hairymnstr/usb-thinkpad-keyboard/sch/thinkpad_keyboard_usb.kicad_pcb

## KiCad design sch/thinkpad_keyboard_usb.kicad_pcb (2025-03-06)

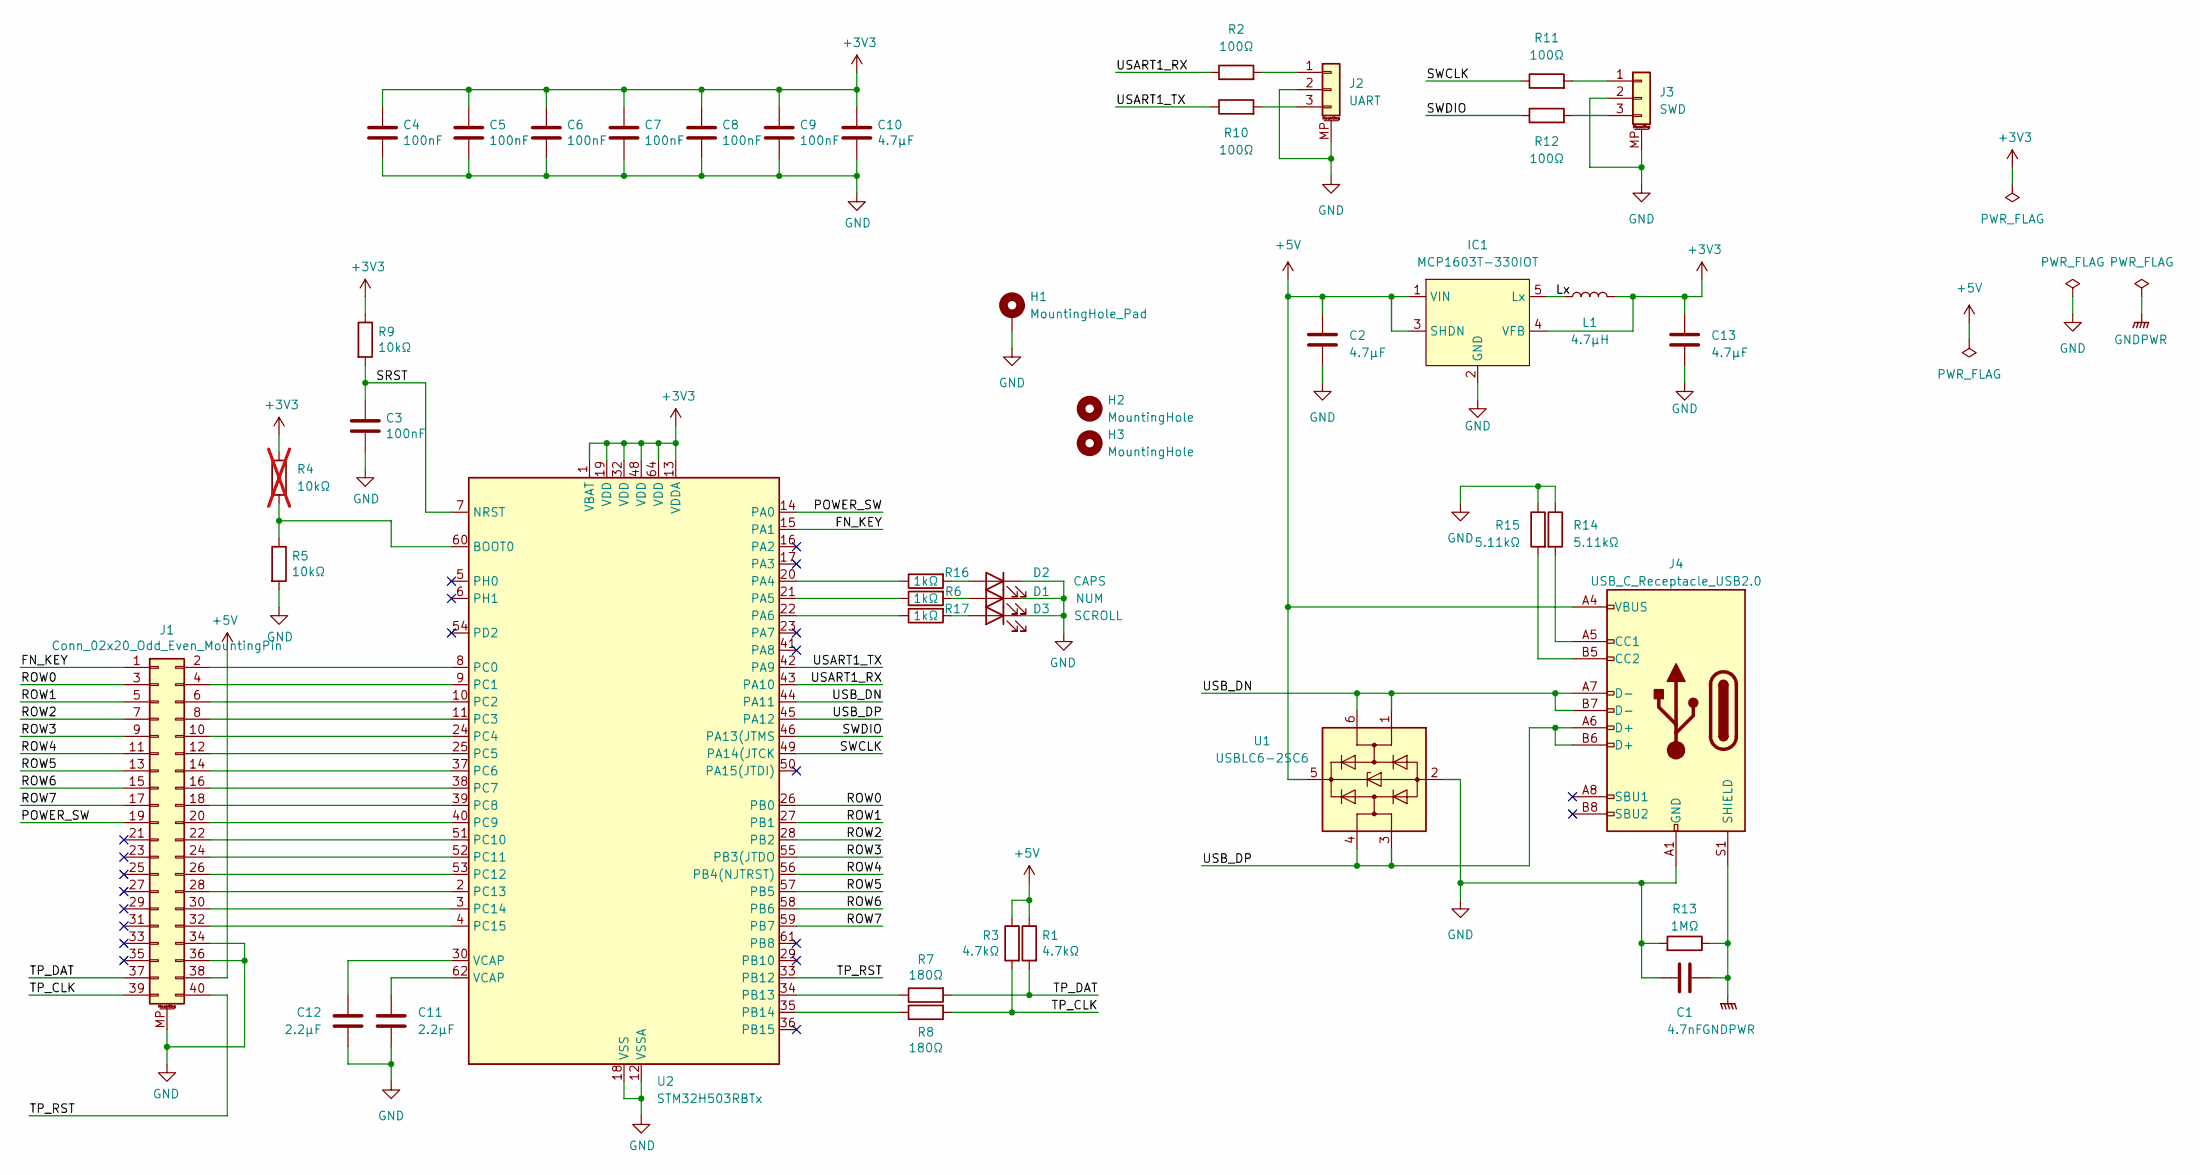
[picture p1: schematic thinkpad_keyboard_usb.kicad_sch]

Parts:
C1: 4.7nF; C_0805_2012Metric
C2, C10, C13: 4.7µF; C_0805_2012Metric
C3, C4, C5, C6, C7, C8, C9: 100nF; C_0603_1608Metric
C11, C12: 2.2µF; C_0603_1608Metric
D1: NUM; D_0603_1608Metric
D2: CAPS; D_0603_1608Metric
D3: SCROLL; D_0603_1608Metric
H1: MountingHole_Pad; MountingHole_2.2mm_M2_Pad
H2, H3: MountingHole; MountingHole_3.2mm_M3
IC1: MCP1603T-330IOT; TSOT-23-5
J1: Conn_02x20_Odd_Even_MountingPin; MOLEX_SLIMSTACK_54363_02x20_P0.5mm
J2: UART; JST_SH_SM03B-SRSS-TB_1x03-1MP_P1.00mm_Horizontal
J3: SWD; JST_SH_SM03B-SRSS-TB_1x03-1MP_P1.00mm_Horizontal
J4: USB_C_Receptacle_USB2.0; USB_C_Receptacle_GCT_USB4085
L1: 4.7µH; L_Wuerth_WE-TPC-3816
R1, R3: 4.7kΩ; R_0603_1608Metric
R2, R10, R11, R12: 100Ω; R_0603_1608Metric
R4: 10kΩ; R_0603_1608Metric; not fitted
R5, R9: 10kΩ; R_0603_1608Metric
R6, R16, R17: 1kΩ; R_0603_1608Metric
R7, R8: 180Ω; R_0603_1608Metric
R13: 1MΩ; R_0603_1608Metric
R14, R15: 5.11kΩ; R_0603_1608Metric
U1: USBLC6-2SC6; SOT-23-6
U2: STM32H503RBTx; LQFP-64_10x10mm_P0.5mm

Connections:
+3V3: C4.1, C5.1, C6.1, C7.1, C8.1, C9.1, C10.1, C13.1, IC1.4 (VFB), L1.2, R4.1, R9.1, U2.1 (VBAT), U2.13 (VDDA), U2.19 (VDD), U2.32 (VDD), U2.48 (VDD), U2.64 (VDD)
+5V: C2.1, IC1.1 (VIN), IC1.3 (SHDN), J1.38, J4.A4 (VBUS), J4.A9 (VBUS), J4.B4 (VBUS), J4.B9 (VBUS), R1.1, R3.1, U1.5 (VBUS)
/FN_KEY: J1.1, U2.15 (PA1)
/Lx: IC1.5 (Lx), L1.1
/POWER_SW: J1.19, U2.14 (PA0)
/ROW0: J1.3, U2.26 (PB0)
/ROW1: J1.5, U2.27 (PB1)
/ROW2: J1.7, U2.28 (PB2)
/ROW3: J1.9, U2.55 (PB3(JTDO)
/ROW4: J1.11, U2.56 (PB4(NJTRST))
/ROW5: J1.13, U2.57 (PB5)
/ROW6: J1.15, U2.58 (PB6)
/ROW7: J1.17, U2.59 (PB7)
/SRST: C3.1, R9.2, U2.7 (NRST)
/SWCLK: R11.1, U2.49 (PA14(JTCK)
/SWDIO: R12.1, U2.46 (PA13(JTMS)
/TP_CLK: J1.39, R3.2, R8.2
/TP_DAT: J1.37, R1.2, R7.2
/TP_RST: J1.40, U2.33 (PB12)
/USART1_RX: R2.1, U2.43 (PA10)
/USART1_TX: R10.1, U2.42 (PA9)
/USB_DN: J4.A7 (D-), J4.B7 (D-), U1.1 (I/O1), U1.6 (I/O1), U2.44 (PA11)
/USB_DP: J4.A6 (D+), J4.B6 (D+), U1.3 (I/O2), U1.4 (I/O2), U2.45 (PA12)
GND: C1.2, C2.2, C3.2, C4.2, C5.2, C6.2, C7.2, C8.2, C9.2, C10.2, C11.2, C12.2, C13.2, D1.1 (K), D2.1 (K), D3.1 (K), H1.1, IC1.2 (GND), J1.34, J1.36, J1.MP (MountPin), J2.2, J2.MP (MountPin), J3.2, J3.MP (MountPin), J4.A1 (GND), J4.A12 (GND), J4.B1 (GND), J4.B12 (GND), R5.2, R13.2, R14.1, R15.1, U1.2 (GND), U2.12 (VSSA), U2.18 (VSS), U2.31 (VSS), U2.47 (VSS), U2.63 (VSS)
GNDPWR: C1.1, J4.S1 (SHIELD), R13.1
unnamed: C11.1, U2.62 (VCAP)
unnamed: C12.1, U2.30 (VCAP)
unnamed: D1.2 (A), R6.2
unnamed: D2.2 (A), R16.2
unnamed: D3.2 (A), R17.2
unnamed: J1.2, U2.8 (PC0)
unnamed: J1.4, U2.9 (PC1)
unnamed: J1.6, U2.10 (PC2)
unnamed: J1.8, U2.11 (PC3)
unnamed: J1.10, U2.24 (PC4)
unnamed: J1.12, U2.25 (PC5)
unnamed: J1.14, U2.37 (PC6)
unnamed: J1.16, U2.38 (PC7)
unnamed: J1.18, U2.39 (PC8)
unnamed: J1.20, U2.40 (PC9)
unnamed: J1.22, U2.51 (PC10)
unnamed: J1.24, U2.52 (PC11)
unnamed: J1.26, U2.53 (PC12)
unnamed: J1.28, U2.2 (PC13)
unnamed: J1.30, U2.3 (PC14)
unnamed: J1.32, U2.4 (PC15)
unnamed: J2.1, R2.2
unnamed: J2.3, R10.2
unnamed: J3.1, R11.2
unnamed: J3.3, R12.2
unnamed: J4.A5 (CC1), R14.2
unnamed: J4.B5 (CC2), R15.2
unnamed: R4.2, R5.1, U2.60 (BOOT0)
unnamed: R16.1, U2.20 (PA4)
unnamed: R6.1, U2.21 (PA5)
unnamed: R17.1, U2.22 (PA6)
unnamed: R7.1, U2.34 (PB13)
unnamed: R8.1, U2.35 (PB14)

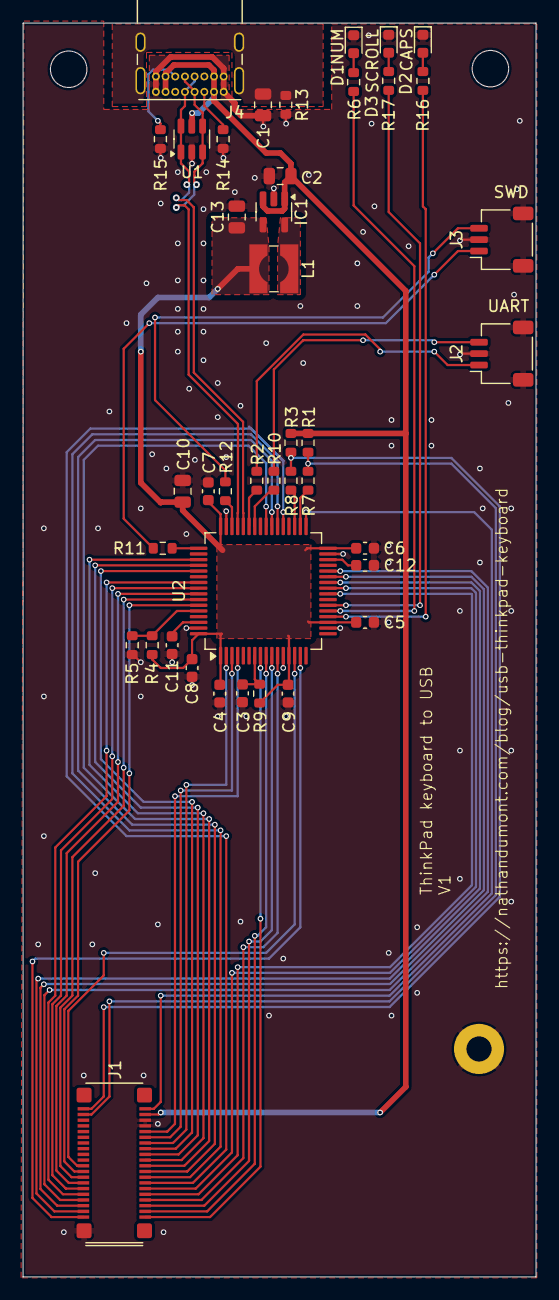
[picture p2: board thinkpad_keyboard_usb.kicad_pcb from above]

Board: 2 copper layers, 45.0 x 110.0 mm, 44 parts (0 on the bottom side), 58 nets.
