hairymnstr/usb-thinkpad-keyboard/fw/thinkpad_keyboard_usb.ioc

Mcu.UserName=STM32H503RBTx
PA0.GPIO_Label=POWER_SW
PA0.Signal=GPIO_Input
PA1.GPIO_Label=FN_KEY
PA1.Signal=GPIO_Input
PA10.Signal=USART1_RX
PA11.Signal=USB_DM
PA12.Signal=USB_DP
PA13(JTMS/SWDIO).Signal=DEBUG_JTMS-SWDIO
PA14(JTCK/SWCLK).Signal=DEBUG_JTCK-SWCLK
PA5.GPIO_Label=LED
PA5.Signal=GPIO_Output
PA9.Signal=USART1_TX
PB0.Signal=GPIO_Output
PB1.Signal=GPIO_Output
PB12.GPIO_Label=TP_RST
PB12.Signal=GPIO_Output
PB13.GPIO_Label=TP_DAT
PB13.Signal=GPIO_Input
PB14.GPIO_Label=TP_CLK
PB14.Signal=GPIO_Output
PB15.GPIO_Label=FN_KEY
PB15.Signal=GPIO_Input
PB2.Signal=GPIO_Output
PB3(JTDO/TRACESWO).Signal=GPIO_Output
PB4(NJTRST).Signal=GPIO_Output
PB5.Signal=GPIO_Output
PB6.Signal=GPIO_Output
PB7.Signal=GPIO_Output
PC0.Signal=GPIO_Input
PC1.Signal=GPIO_Input
PC10.Signal=GPIO_Input
PC11.Signal=GPIO_Input
PC12.Signal=GPIO_Input
PC13.Signal=GPIO_Input
PC14-OSC32_IN(OSC32_IN).Signal=GPIO_Input
PC15-OSC32_OUT(OSC32_OUT).Signal=GPIO_Input
PC2.Signal=GPIO_Input
PC3.Signal=GPIO_Input
PC4.Signal=GPIO_Input
PC5.Signal=GPIO_Input
PC6.Signal=GPIO_Input
PC7.Signal=GPIO_Input
PC8.Signal=GPIO_Input
PC9.Signal=GPIO_Input
