hairymnstr/usb-thinkpad-keyboard/(commit log)

2025-03-06 Initial commit, board design done but mech layout might need improving
    [thinkpad_keyboard_usb.kicad_pcb, thinkpad_keyboard_usb.kicad_sch]
2025-03-06 Added board name and version to silk
    [thinkpad_keyboard_usb.kicad_pcb]
